mtwieg/Maker-Gradient-Amplifier/README.md

# Maker-Gradient-Amplifier
Design documents for DIY gradient amplifier
