mtwieg/Maker-Gradient-Amplifier/SSmodel_AC_closedloop.png

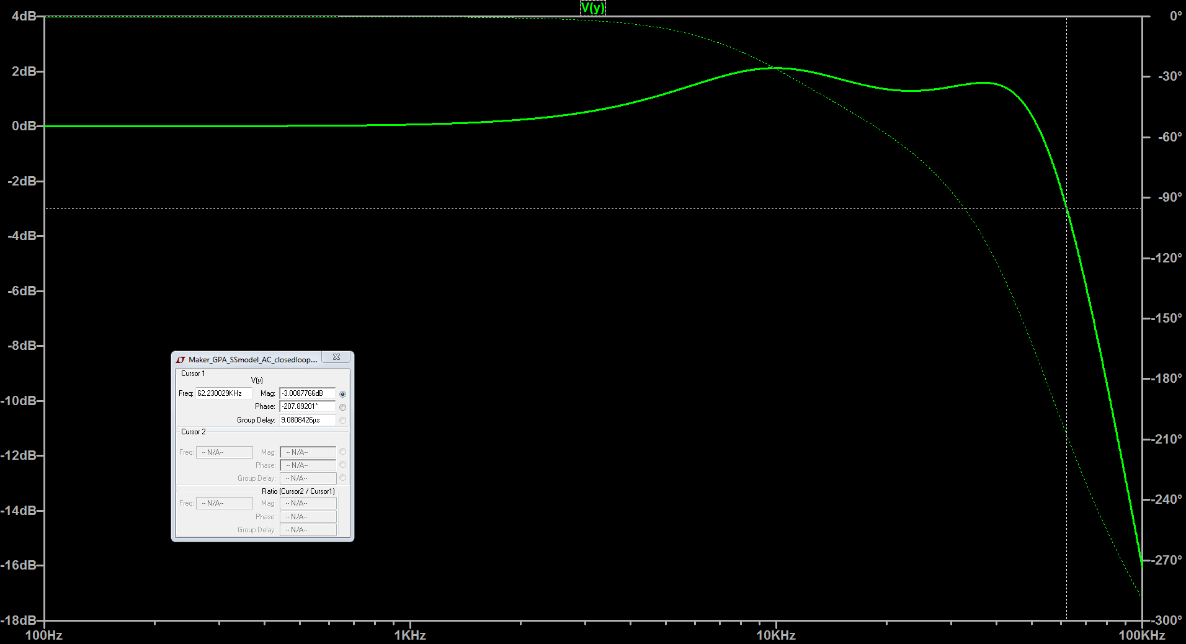
SSmodel_AC_closedloop.png
