mtwieg/Maker-Gradient-Amplifier/SSmodel_AC_openloop.png

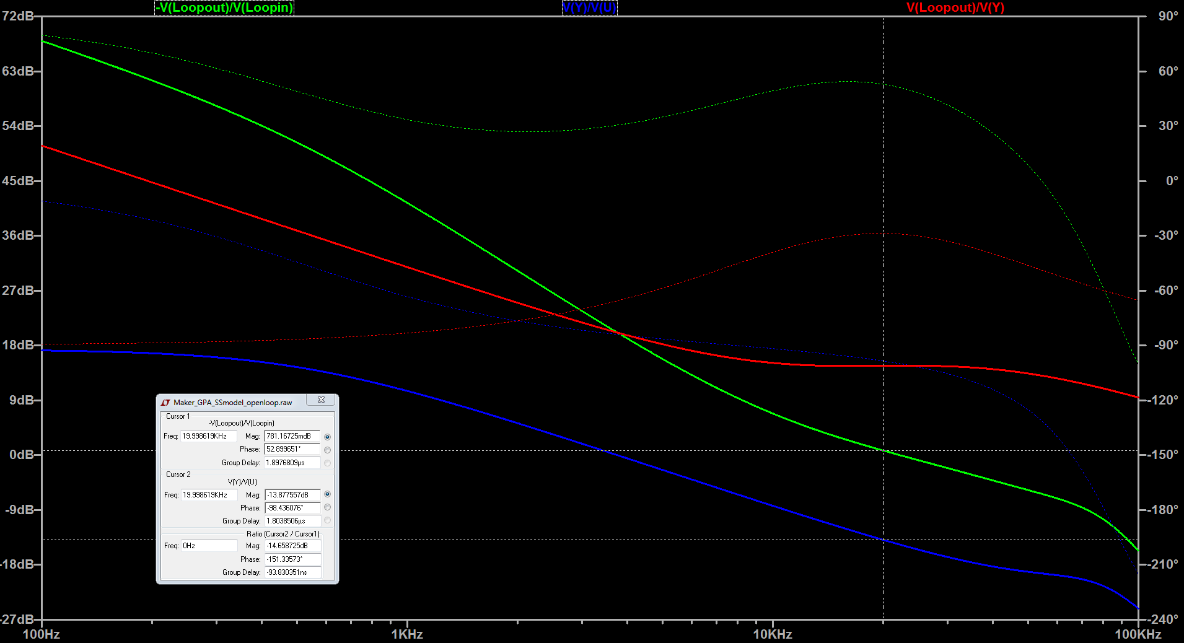
SSmodel_AC_openloop.png
