mtwieg/Maker-Gradient-Amplifier/SSmodel_tran_closedloop.png

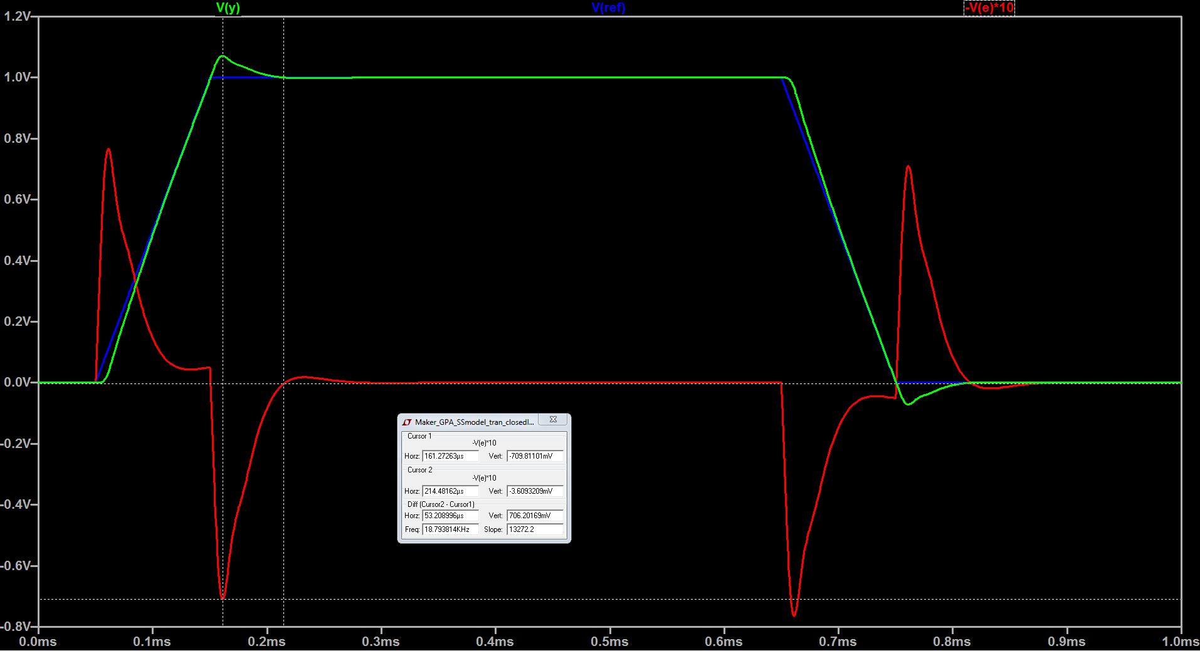
SSmodel_tran_closedloop.png
