mtwieg/Maker-Gradient-Amplifier/Maker GPA V100 BOM.xlsx

QTY | Part Schematic | Value | Mfg Part Num | Mfg name | VID | Vendor Part Num | Description | Package | Myorder
1 | X101 |  | DC1446A | Linear Technology | Linear Technology | DC1446A | LTC6909 DEMO BOARD | Module | 1.00
4 | X301 |  | G224V13 | Pololu | Pololu | 2992 | G2 High-Power Motor Driver 24v13 | Module | 2.00
4 | L301 | 1mH | SC-05-10J | KEMET | Digikey | 399-10651-ND | COMMON MODE CHOKE 1MH 5A 2LN TH | Vertical 4 PC Pin | 3.00
4 | C307 | 39uF 50V | RNU1H390MDN1KX | Nichicon | Digikey | 493-6636-1-ND | CAP ALUM POLY 39UF 20% 50V T/H | Radial | 3.00
4 | C306 | 2200uF 50V | EST228M050AN2AA | KEMET | Digikey | 399-6616-ND | CAP ALUM 2200UF 20% 50V RADIAL | Radial | 3.00
4 | U301 |  | HCPL-2231-000E | Broadcom Limited | Digikey | 516-1582-5-ND | OPTOISO 3.75KV 2CH PSH PULL 8DIP | 8-DIP | 3.00
4 | X302 |  | OSTTD040161 | On Shore Technology Inc. | Digikey | ED2620-ND | TERMINAL BLOCK 5MM HOR 4POS PCB | Vertical | 3.00
1 | U401 |  | LA 130-P | LEM USA Inc | Digikey | 398-1154-ND | SENSOR CURRENT HALL 130A AC/DC | Module | 4.00
1 | U202 |  | LM339AN | Texas Instruments | Digikey | 296-6605-5-ND | IC QUAD DIFF COMPARATOR 14-DIP | 14-PDIP | 4.00
1 | U501 |  | MAX322CPA+ | Maxim Integrated | Digikey | MAX322CPA+-ND | IC SWITCH DUAL SPST 8DIP | 8-PDIP | 4.00
1 | U104 |  | MC79M05BTG | ON Semiconductor | Digikey | MC79M05BTGOS-ND | IC REG LINEAR -5V 500MA TO220AB | TO220AB | 4.00
5 | U103, U302 |  | MC7805CTG | ON Semiconductor | Digikey | MC7805CTGOS-ND | IC REG LINEAR 5V 1A TO220AB | TO-220AB | 4.00
1 | U102 |  | MC7809CTG | ON Semiconductor | Digikey | MC7809CTGOS-ND | IC REG LINEAR 9V 1A TO220AB | TO-220AB | 4.00
1 | U101 |  | MC7812CTG | ON Semiconductor | Digikey | MC7812CTGOS-ND | IC REG LINEAR 12V 1A TO220AB | TO-220AB | 4.00
1 | U105 |  | MC7912CTG | ON Semiconductor | Digikey | MC7912CTGOS-ND | IC REG LINEAR -12V 1A TO220AB | TO-220AB | 4.00
2 | U201, U502 |  | TLC084AIN | Texas Instruments | Digikey | 296-7281-5-ND | IC OPAMP GP 10MHZ 14DIP | 14-PDIP | 4.00
1 | S501 |  | TL1105EF250Q7.3RED | E-Switch | Digikey | EG1832-ND | SWITCH TACTILE SPST-NO 0.05A 12V | Vertical | 5.00
8 | D301, D302, D701, D702, D703, D704, D705, D706 |  | 1N4148-T50R | ON Semiconductor | Digikey | 1N4148-T50RCT-ND | DIODE GEN PURP 100V 200MA DO35 | DO-35 | 5.00
2 | D401, D402 |  | 1N5819 | ON Semiconductor | Digikey | 1N5819FSCT-ND | DIODE SCHOTTKY 40V 1A DO41 | DO-41 | 5.00
1 | L401 | 3mH | SC-10-30J | KEMET | Digikey | 399-10657-ND | COMMON MODE CHOKE 3MH 10A 2LN TH | Vertical 4 PC Pin | 6.00
4 | C402, C403, C404, C405 | 10nF | 942C20S1K-F | Cornell Dubilier Electronics (CDE) | Digikey | 338-3527-ND | CAP FILM 10000PF 10% 2KVDC AXIAL | Axial | 6.00
4 | L402, L403, L404, L405 | 10uH | 74435581000 | Wurth Electronics Inc | Digikey | 732-4235-1-ND | FIXED IND 10UH 21A 3.4 MOHM SMD | 2212 | 6.00
1 | C401 | 100nF | 940C16P1K-F | Cornell Dubilier Electronics (CDE) | Digikey | 338-1165-ND | CAP FILM 0.1UF 10% 1.6KVDC AXIAL | Axial | 6.00
4 | C207, C208, C209, C210 | 1000pF | C322C102F1G5TA | KEMET | Digikey | 399-13986-ND | CAP CER 1000PF 1% 100V C0G RAD | Radial | 6.00
10 | C205, C206, C211, C212, C301, C502, C503 | 0.1uF | FG28X7R1H104KNT06 | TDK Corporation | Digikey | 445-173588-1-ND | CAP CER 0.1UF 50V X7R RADIAL | Radial | 6.00
11 | C101, C102, C103, C104, C105, C406, C407,C308 | 1uF | FG28X5R1H105KRT06 | TDK Corporation | Digikey | 445-173579-1-ND | CAP CER 1UF 50V X5R RADIAL | Radial | 6.00
9 | C106, C107, C108, C109, C110, C304 | 22uF | FG14X5R1E226MRT06 | TDK Corporation | Digikey | 445-173129-1-ND | CAP CER 22UF 25V X5R RADIAL | Radial | 6.00
4 |  |  | 319030007 | Seeed Technology Co., Ltd | Digikey | 1597-1267-ND | MINI BREAD BOARD 4.5X3.5CM-RED |  | 7.00
1 |  |  | ATS-EXL68-300-R0 | Advanced Thermal Solutions Inc. | Digikey | ATS2196-ND | HEATSINK AL6063 300X35X25MM |  | 7.00
4 |  |  | TG6050-24-21.01-0.5 | t-Global Technology | Digikey | TG6050-24-21.01-0.5 | THERMAL PAD 24X21.01X0.5MM |  | 7.00
