mtwieg/Maker-Gradient-Amplifier/Maker_GPA_switchingmodel.asc

B1: bv; V=(!((V(U)>=V(ramp1))+(V(U)>=V(ramp1_del)))-0.5)
B2: bv; V=(((V(U)>=V(ramp1))&(V(U)>=V(ramp1_del)))-0.5)
B3: bv; V=(!((V(U)>=V(ramp2))+(V(U)>=V(ramp2_del)))-0.5)
B4: bv; V=(((V(U)>=V(ramp2))&(V(U)>=V(ramp2_del)))-0.5)
B5: bv; V=(!((V(U)>=V(ramp3))+(V(U)>=V(ramp3_del)))-0.5)
B6: bv; V=(((V(U)>=V(ramp3))&(V(U)>=V(ramp3_del)))-0.5)
B7: bv; V=(((V(U)>=V(ramp4))&(V(U)>=V(ramp4_del)))-0.5)
B8: bv; V=(!((V(U)>=V(ramp4))+(V(U)>=V(ramp4_del)))-0.5)
C1: cap; {C_PE}; Rser={C_PE_ESR}
C2: cap; {C_PE}; Rser={C_PE_ESR}
C3: cap; {C_PE}; Rser={C_PE_ESR}
C5: cap; 20n
C6: cap; 100n
C7: cap; {Cb1}
C8: cap; {Cb1}
C9: cap; {Cb1}
C10: cap; {Cb2}
C11: cap; {Cb2}
C12: cap; {Cb2}
C13: cap; {Cb1}
C14: cap; {Cb2}
C15: cap; {C_PE}; Rser={C_PE_ESR}
C17: cap; {Coss}
C18: cap; {Coss}
C19: cap; {Coss}
C20: cap; {Coss}
C21: cap; {Coss}
C22: cap; {Coss}
C23: cap; {Coss}
C24: cap; {Coss}
C25: cap; {Coss}
C26: cap; {Coss}
C27: cap; {Coss}
C28: cap; {Coss}
C29: cap; {Coss}
C30: cap; {Coss}
C31: cap; {Coss}
C32: cap; {Coss}
C33: cap; 174p
C34: cap; 10n
C35: cap; 10n
D1: diode
D2: diode
D3: diode
D4: diode
D5: diode
D6: diode
D7: diode
D8: diode
D9: diode
D10: diode
D11: diode
D12: diode
D13: diode
D14: diode
D15: diode
D16: diode
L2: ind2; {Lcm}; Rser={Lcm_ESR}
L3: ind2; {Lcm}; Rser={Lcm_ESR}
L4: ind2; {Lcm}; Rser={Lcm_ESR}
L5: ind2; {Lcm}; Rser={Lcm_ESR}
L6: ind2; {Lcm}; Rser={Lcm_ESR}
L7: ind2; {Lcm}; Rser={Lcm_ESR}
L8: ind2; {Lcm}; Rser={Lcm_ESR}
L9: ind2; {Lcm}; Rser={Lcm_ESR}
L11: ind2; 20µ; Rser=10m
L12: ind2; 20µ; Rser=10m
L13: ind2; 3m; Rser=10m
L14: ind2; 3m; Rser=10m
LG: ind2; {LG}
R1: res; 0.1Meg
R2: res; 1m
R3: res; 1m
R4: res; 10k
R5: res; 0.1Meg
R6: res; 0.1Meg
R7: res; {Rcm_damp*2}
R8: res; {Cb1_ESR}
R9: res; {Rcm_damp*2}
R10: res; {Rcm_damp*2}
R11: res; {Cb1_ESR}
R12: res; {Cb1_ESR}
R13: res; {Rcm_damp*2}
R14: res; {Cb1_ESR}
R15: res; 0.1Meg
R16: res; 1m
R17: res; 1m
R18: res; {RG}
R19: res; 20
R20: res; {Rcm_damp*2}
R21: res; {Rcm_damp*2}
R22: res; {Rcm_damp*2}
R23: res; {Rcm_damp*2}
R24: res; 100k
S1: sw; MySwitch
S2: sw; MySwitch
S3: sw; MySwitch
S4: sw; MySwitch
S5: sw; MySwitch
S6: sw; MySwitch
S7: sw; MySwitch
S8: sw; MySwitch
S9: sw; MySwitch
S10: sw; MySwitch
S11: sw; MySwitch
S12: sw; MySwitch
S13: sw; MySwitch
S14: sw; MySwitch
S15: sw; MySwitch
S16: sw; MySwitch
V2: voltage; PULSE({-Vramp/2} {Vramp/2} {td} {0.5/f} {0.5/f} 0 {1/f})
V3: voltage; PULSE({-Vramp/2} {Vramp/2} {1/(f*N)+td} {0.5/f} {0.5/f} 0 {1/f})
V4: voltage; PULSE({Vramp/2} {-Vramp/2} {td} {0.5/f} {0.5/f} 0 {1/f})
V5: voltage; PULSE({Vramp/2} {-Vramp/2} {1/(f*N)+td} {0.5/f} {0.5/f} 0 {1/f})
V7: voltage; {VDD}
V8: voltage; {VDD}
V9: voltage; {VDD}
V12: voltage; {VDD}
V13: voltage; PULSE({-Vramp/2} {Vramp/2} 0 {0.5/f} {0.5/f} 0 {1/f})
V14: voltage; PULSE({-Vramp/2} {Vramp/2} {1/(f*N)} {0.5/f} {0.5/f} 0 {1/f})
V17: voltage; 215m
V18: voltage; PULSE({-Vramp/20} {Vramp/20} 0 {0.5*tstop/2} {0.5*tstop/2} 0 {tstop/2})
V19: voltage; PULSE({Vramp/2} {-Vramp/2} 0 {0.5/f} {0.5/f} 0 {1/f})
V20: voltage; PULSE({Vramp/2} {-Vramp/2} {1/(f*N)} {0.5/f} {0.5/f} 0 {1/f})
Named nets: Vo1b, Vo1a, Vs1, Vd1, Vo2b, Vo2a, Vs2, Vd2, Vo3b, Vo3a, Vs3, Vd3, 0, Vo4a, Vo4b, Vs4, Vd4, ramp1, ramp2, ramp3, ramp4, U, ramp1_del, ramp2_del, ramp3_del, ramp4_del, gateH_1, gateL_1, gateH_2, gateL_2, gateH_3, gateL_3, gateH_4, gateL_4
.model MySwitch SW(Ron=0.006 Roff=1Meg Vt=0 Vh=0 Lser=0 Vser=0)
.param Coss=1n
.param td=100n
.param f=50k
.param N=4
.param Vramp=8
.param VDD=30
.param C_PE=40n
.param C_PE_ESR=10m
.tran 0 {tstop} 0 10n
.ic I(LG)=0
.param LG=273u
.param RG=0.3
.param Kcm=0.995
.param Lcm=1m
.param Rcm_damp=10k
.param Lcm_ESR=0.1
Kcm1 L2 L3 {Kcm}
Kcm2 L6 L7 {Kcm}
Kcm3 L8 L9 {Kcm}
Kcm4 L4 L5 {Kcm}
.param tstop=10m
MOSFETs are modeled with behvioral switches
Define Coss and dead time
Kcm5 L13 L14 1
DC power supplies with capacitance to earth
Cascaded bridges with common mode chokes
Load coil with output filter
.param Cb1=39u
.param Cb1_ESR=40m
.param Cb2=1u
Common mode chokes with coupling factor,
Damping resistance, and ESR
Bypass capacitors
Cb1 is an electrolytic type with ESR
Cb2 is a smaller cap with zero ESR
Set up switching frequency
and supply voltages
Simulation setup
Gate drive synthesis with dead time
Control input u(t)
Use static DC setpoint, or pulse waveform
