mtwieg/Maker-Gradient-Amplifier/Maker_GPA_SSmodel_AC_closedloop.asc

B1: bv; V=absdelay((2*(V(Duty)-0.5)*VM*Nph),pwm_delay)
B3: bv; V=-(1*V(Ref)-1*V(Y))
B4: bv; V=(V(U)/Vramp+0.5)
B5: bi2; I=I(L1)*Iratio
B6: bv; V={K}
B7: bv; V={C3}
B8: bv; V={C2}
B9: bv; V={C1}
B10: bv; V={R3}
B11: bv; V={R2}
B12: bv; V={R1}
C4: cap; {C1}
C5: cap; {C3}
C6: cap; {C2}
C7: cap; 25n
C8: cap; 100n
C9: cap; 1n
C16: cap; 174p
L1: ind2; {LG}
L2: ind2; 40µ; Rser=10m
R1: res; {RG}
R6: res; {R1}
R7: res; {R2}
R8: res; {R3}
R9: res; 1000Meg
R10: res; 62
R11: res; 1
R13: res; 20
R17: res; 1
U2: UniversalOpamp2; Avol=10Meg GBW=10Meg Slew=10Meg
V1: voltage; 5
V2: voltage; 5
V3: voltage; PULSE(0 1 50u 100u 100u 500u 1m); AC {if(MODE,1,0)}
V4: voltage; 0; AC {if(MODE,0,1)}
Named nets: 0, 5V, -5V, U, Duty, Y, K, Loopin, Loopout, C3_F, C2_F, C1_F, R3_ohms, R2_ohms, R1_ohms, t3out, Ref, E
Stacked Hbridge output
PWM modulator
Type III compensator
.param Iratio=4/1000
.param VM=30
.param Nph=4
.param pwm_delay=1.2u
.param Vramp=8
.ac dec 1k 100 100k
.param MODE=1
Current sensor
and burden resistor
.param fc=20k
.param G_fc={0.184}
.param phaseboost=62
 
.param K={(tan((phaseboost/4+45)*3.1416/180))**2}
.param H_fc={1/G_fc}
.param R1=3.3k
 
.param C2={1/(2*3.1416*fc*H_fc*R1)}
.param C1={C2*(K-1)}
.param R2={sqrt(K)/(2*3.1416*fc*C1)}
.param R3={R1/(K-1)}
.param C3={1/(2*3.1416*fc*R3*sqrt(K))}
Perturbation for open loop gain
Load coil
.param LG=273u
.param RG=1
Reference input
Perturbation for closed loop gain
Error amplifier
;op dec 1k 100 1meg
The component values for the type III compensator are calculated automatically
Based on the specified fc, G(fc), and phaseboost
To view the resulting component values, set simulation type to "DC op pnt" and run
The component values are given by the voltages of these sources
To model AC transfer functions, use .ac simulation
For open loop measurement, set MODE=0
Total loop gain is -V(Loopout)/V(Loopin)
Plant gain G is V(Y)/V(U)
Compensator gain H is V(Loopout)/V(Y)
For closed loop measurement, set MODE=1
Closed loop gain is V(Y)
;ac dec 1k 100 100k
;tran 0 1m 0 1u
