mtwieg/Maker-Gradient-Amplifier/Maker_GPA_V100_Schematic_4_16_18.pdf

Regulated supplies for control circuitry | Interleaved clock generator Use LTC6909 demo board
| (DC1446A from Linear Technology)

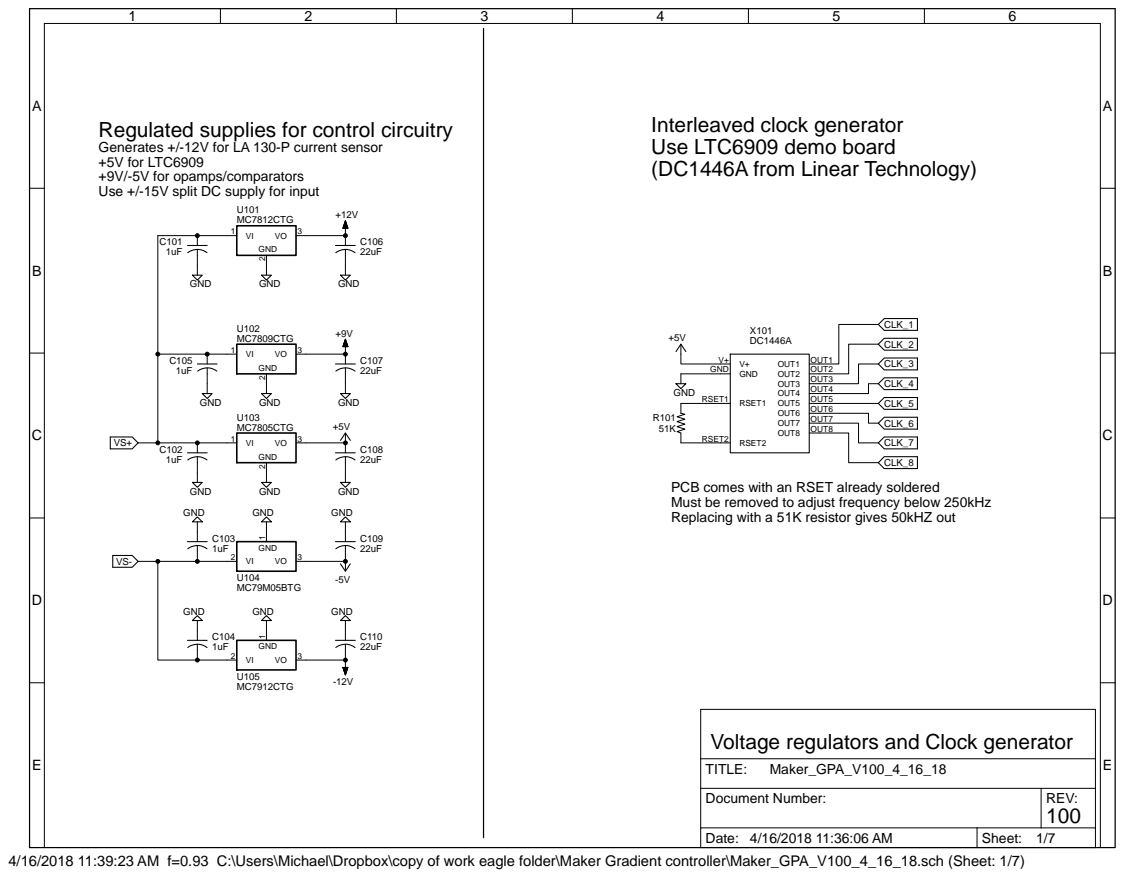
[picture p4: page 1]

Generates +/-12V for LA 130-P current sensor
+5V for LTC6909
+9V/-5V for opamps/comparators
Use +/-15V split DC supply for input

PCB comes with an RSET already soldered
Must be removed to adjust frequency below 250kHz
Replacing with a 51K resistor gives 50kHZ out

Voltage regulators and Clock generator

4/16/2018 11:39:23 AM f=0.93 C:\Users\Michael\Dropbox\copy of work eagle folder\Maker Gradient controller\Maker_GPA_V100_4_16_18.sch (Sheet: 1/7)

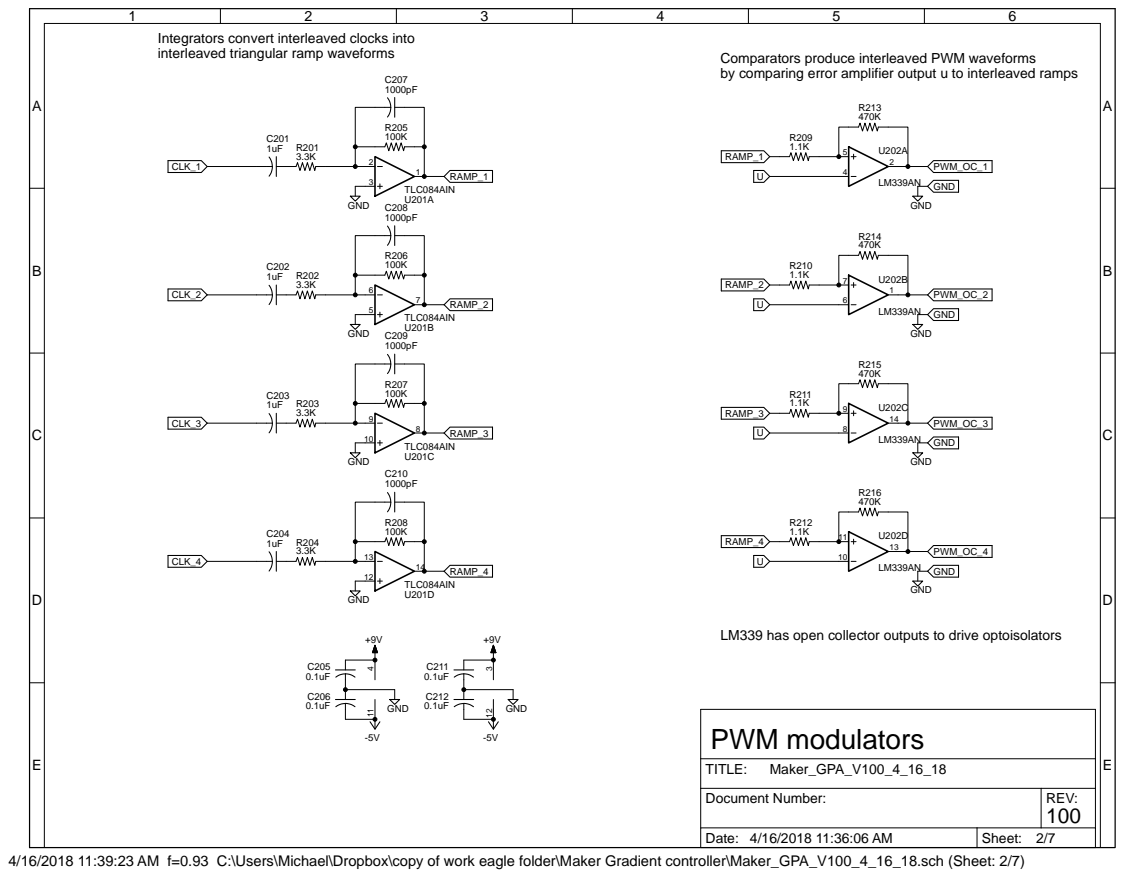
[picture p5: page 2]

Integrators convert interleaved clocks into

by comparing error amplifier output u to interleaved ramps

LM339 has open collector outputs to drive optoisolators

4/16/2018 11:39:23 AM f=0.93 C:\Users\Michael\Dropbox\copy of work eagle folder\Maker Gradient controller\Maker_GPA_V100_4_16_18.sch (Sheet: 2/7)

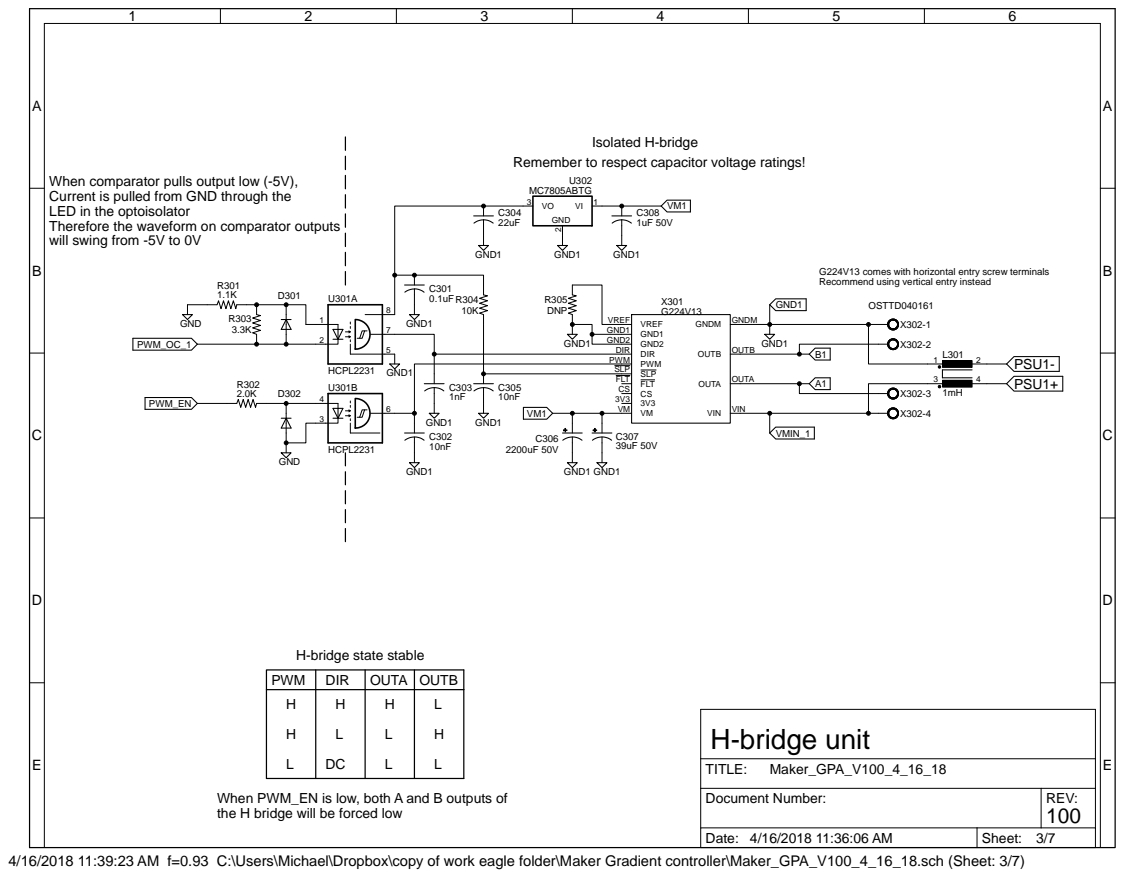
[picture p6: page 3]

Remember to respect capacitor voltage ratings!

When comparator pulls output low (-5V),
Current is pulled from GND through the
LED in the optoisolator
Therefore the waveform on comparator outputs
will swing from -5V to 0V

G224V13 comes with horizontal entry screw terminals
Recommend using vertical entry instead

PWM | DIR | OUTA | OUTB
H H L | H L | H L L | L H L DC

When PWM_EN is low, both A and B outputs of
the H bridge will be forced low

4/16/2018 11:39:23 AM f=0.93 C:\Users\Michael\Dropbox\copy of work eagle folder\Maker Gradient controller\Maker_GPA_V100_4_16_18.sch (Sheet: 3/7)

H-bridge outputs in series | Output filter

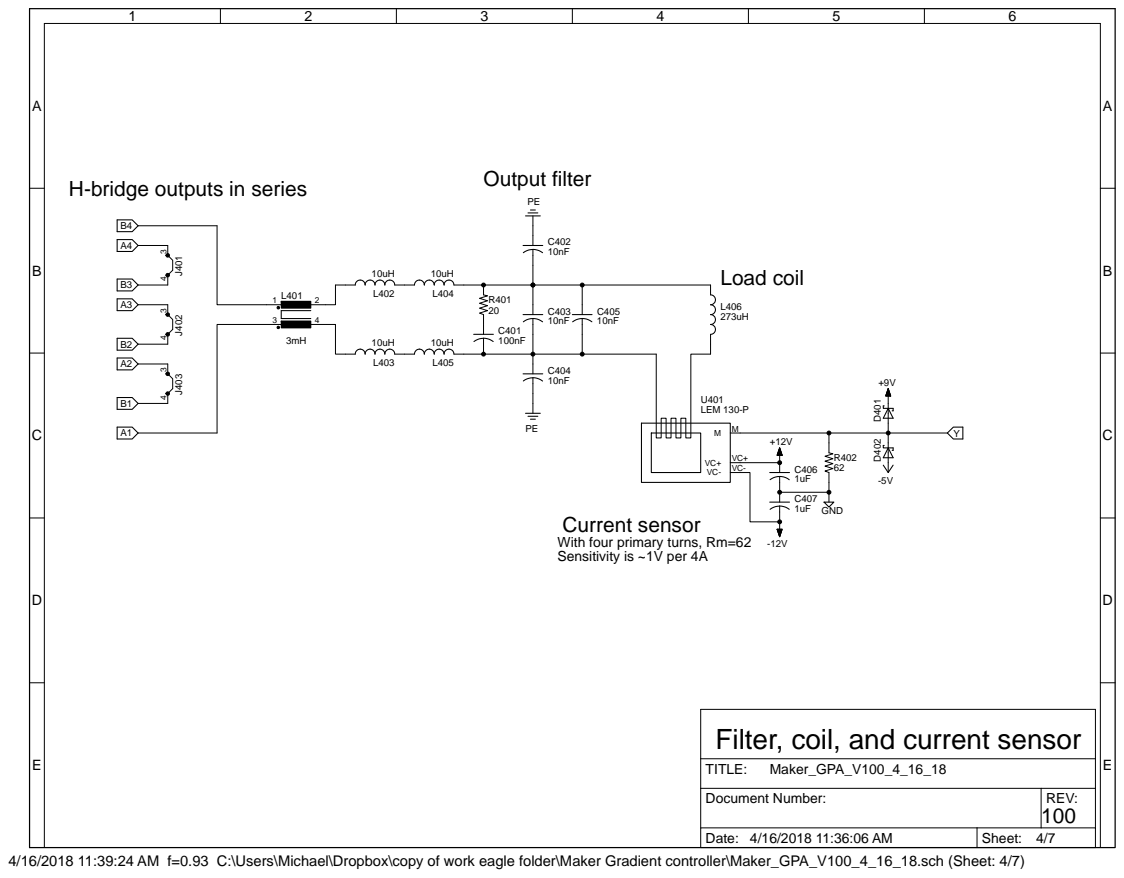
[picture p7: page 4]

Current sensor
With four primary turns, Rm=62
Sensitivity is ~1V per 4A

Filter, coil, and current sensor

4/16/2018 11:39:24 AM f=0.93 C:\Users\Michael\Dropbox\copy of work eagle folder\Maker Gradient controller\Maker_GPA_V100_4_16_18.sch (Sheet: 4/7)

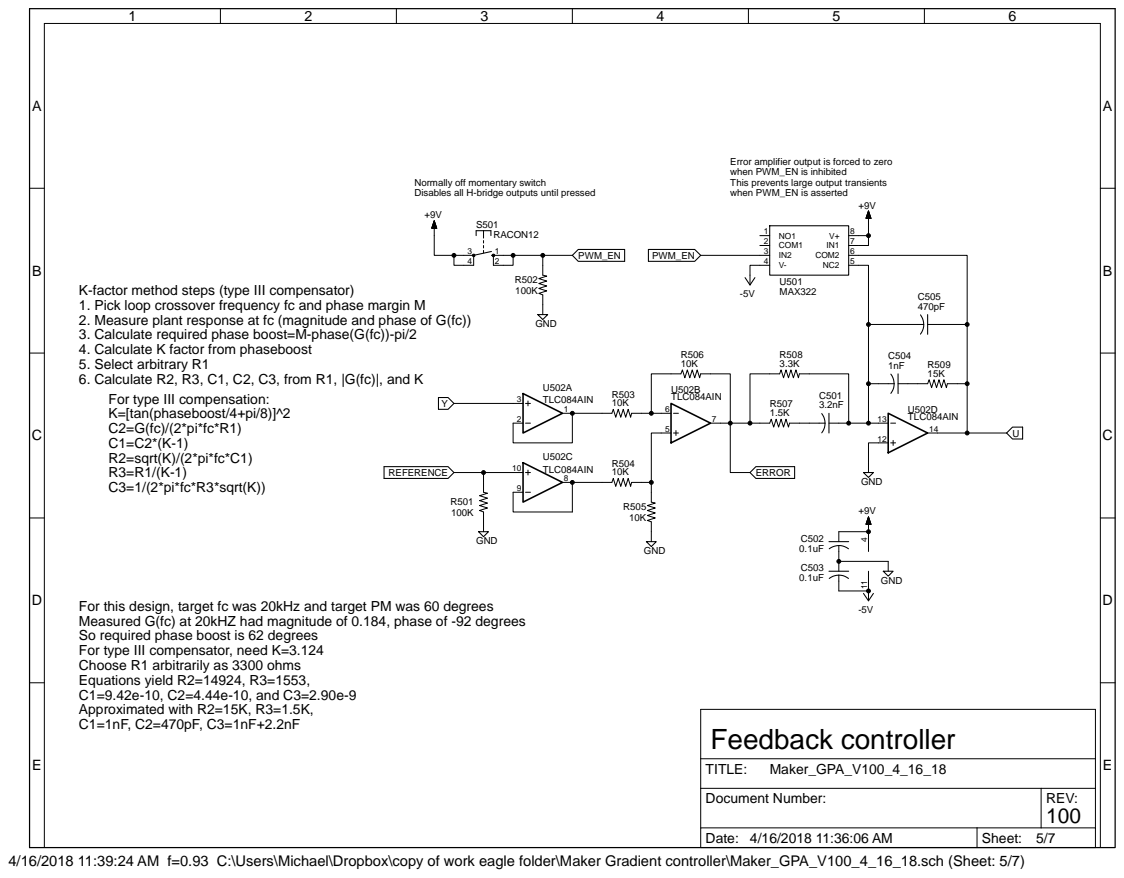
[picture p8: page 5]

Error amplifier output is forced to zero
when PWM_EN is inhibited
This prevents large output transients
when PWM_EN is asserted

Normally off momentary switch
Disables all H-bridge outputs until pressed

K-factor method steps (type III compensator)
1. Pick loop crossover frequency fc and phase margin M
2. Measure plant response at fc (magnitude and phase of G(fc))
3. Calculate required phase boost=M-phase(G(fc))-pi/2
4. Calculate K factor from phaseboost
5. Select arbitrary R1
6. Calculate R2, R3, C1, C2, C3, from R1, |G(fc)|, and K
For type III compensation:
K=[tan(phaseboost/4+pi/8)]^2
R2=sqrt(K)/(2*pi*fc*C1)
C3=1/(2*pi*fc*R3*sqrt(K))

For this design, target fc was 20kHz and target PM was 60 degrees
Measured G(fc) at 20kHZ had magnitude of 0.184, phase of -92 degrees
So required phase boost is 62 degrees
For type III compensator, need K=3.124
Choose R1 arbitrarily as 3300 ohms
Equations yield R2=14924, R3=1553,
C1=9.42e-10, C2=4.44e-10, and C3=2.90e-9
Approximated with R2=15K, R3=1.5K,

4/16/2018 11:39:24 AM f=0.93 C:\Users\Michael\Dropbox\copy of work eagle folder\Maker Gradient controller\Maker_GPA_V100_4_16_18.sch (Sheet: 5/7)
