mtwieg/Maker-Gradient-Amplifier/(commit log)

2018-04-16 BOM and schematic
    new files
    [Maker GPA V100 BOM.xlsx]
2018-06-14 LTspice switching
    Added LTspice model for GPA switching behavior
